olegv142/NRF51PowerMon/doc/rx_display_box.jpg

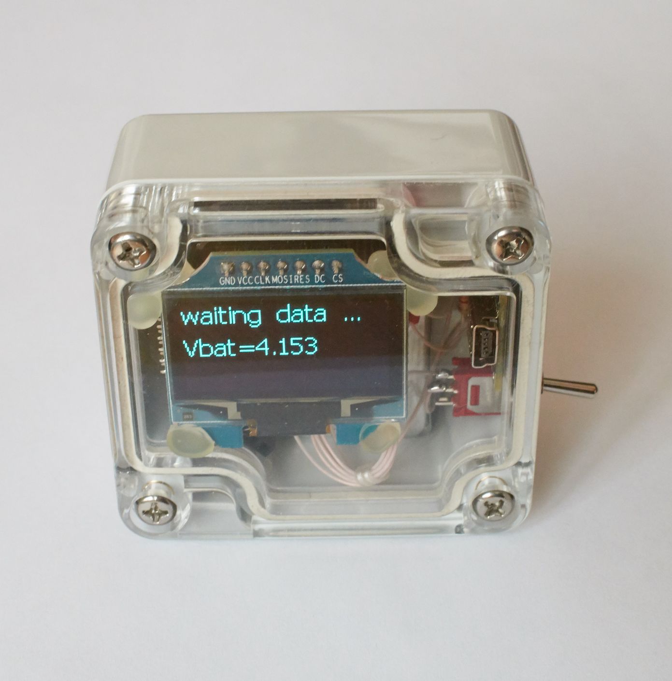
doc/rx_display_box.jpg
