olegv142/NRF51PowerMon/doc/rx_display.jpg

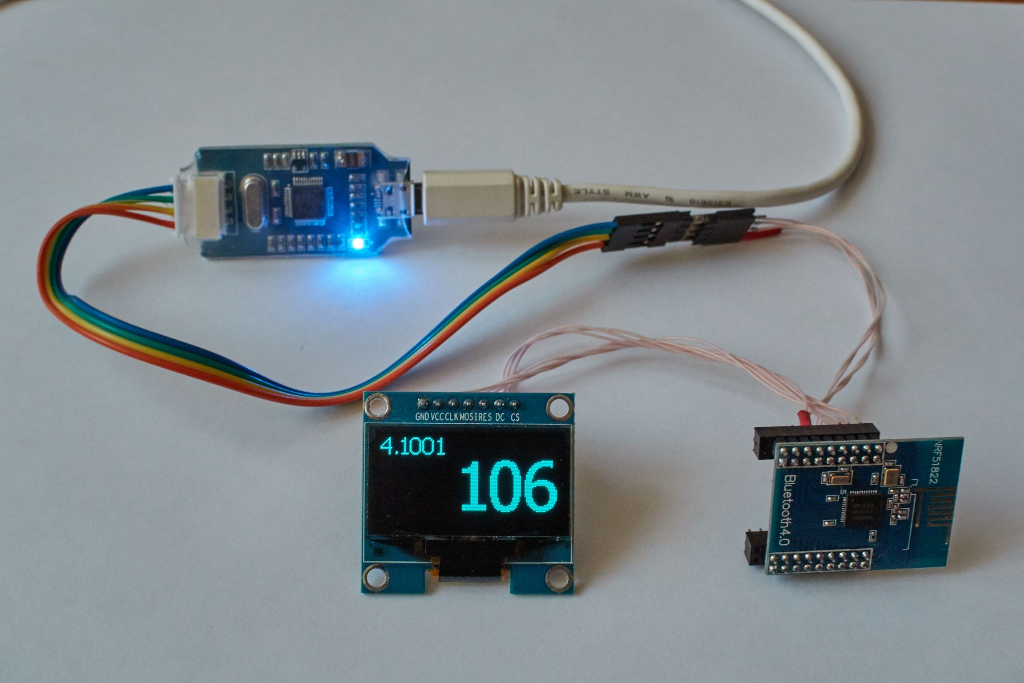
doc/rx_display.jpg
