olegv142/NRF51PowerMon/doc/receiver.jpg

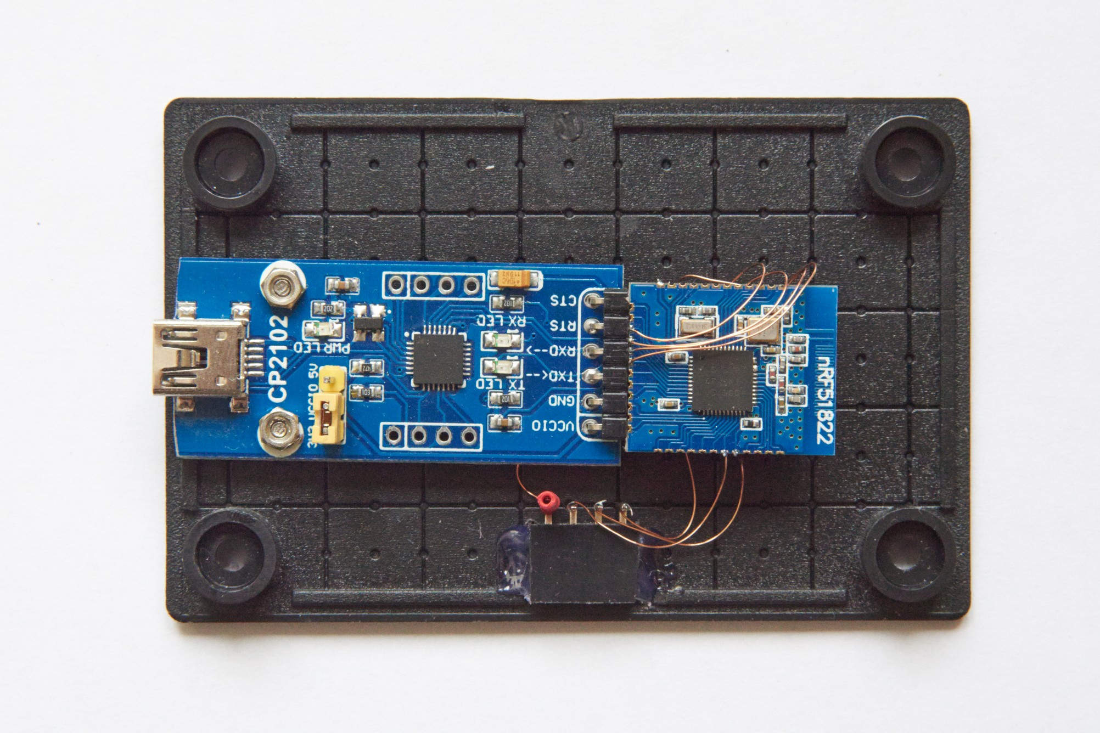
doc/receiver.jpg
