olegv142/NRF51PowerMon/components/device/nrf51_to_nrf52.h

/* Copyright (c) 2015, Nordic Semiconductor ASA
 * All rights reserved.
 *
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
 *   * Neither the name of Nordic Semiconductor ASA nor the names of its
 *     contributors may be used to endorse or promote products derived from
 *     this software without specific prior written permission.
 *
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
 */

#ifndef NRF51_TO_NRF52_H
#define NRF51_TO_NRF52_H

/*lint ++flb "Enter library region */

/* This file is given to prevent your SW from not compiling with the name changes between nRF51 and nRF52 devices. 
 * It redefines the old nRF51 names into the new ones as long as the functionality is still supported. If the 
 * functionality is gone, there old names are not define, so compilation will fail. Note that also includes macros 
 * from the nrf51_deprecated.h file. */

 
/* IRQ */
/* Several peripherals have been added to several indexes. Names of IRQ handlers and IRQ numbers have changed. */
#define UART0_IRQHandler        UARTE0_UART0_IRQHandler
#define SPI0_TWI0_IRQHandler    SPIM0_SPIS0_TWIM0_TWIS0_SPI0_TWI0_IRQHandler
#define SPI1_TWI1_IRQHandler    SPIM1_SPIS1_TWIM1_TWIS1_SPI1_TWI1_IRQHandler
#define ADC_IRQHandler          SAADC_IRQHandler
#define LPCOMP_IRQHandler       COMP_LPCOMP_IRQHandler
#define SWI0_IRQHandler         SWI0_EGU0_IRQHandler
#define SWI1_IRQHandler         SWI1_EGU1_IRQHandler
#define SWI2_IRQHandler         SWI2_EGU2_IRQHandler
#define SWI3_IRQHandler         SWI3_EGU3_IRQHandler
#define SWI4_IRQHandler         SWI4_EGU4_IRQHandler
#define SWI5_IRQHandler         SWI5_EGU5_IRQHandler

#define UART0_IRQn              UARTE0_UART0_IRQn
#define SPI0_TWI0_IRQn          SPIM0_SPIS0_TWIM0_TWIS0_SPI0_TWI0_IRQn
#define SPI1_TWI1_IRQn          SPIM1_SPIS1_TWIM1_TWIS1_SPI1_TWI1_IRQn
#define ADC_IRQn                SAADC_IRQn
#define LPCOMP_IRQn             COMP_LPCOMP_IRQn
#define SWI0_IRQn               SWI0_EGU0_IRQn
#define SWI1_IRQn               SWI1_EGU1_IRQn
#define SWI2_IRQn               SWI2_EGU2_IRQn
#define SWI3_IRQn               SWI3_EGU3_IRQn
#define SWI4_IRQn               SWI4_EGU4_IRQn
#define SWI5_IRQn               SWI5_EGU5_IRQn


/* UICR */
/* Register RBPCONF was renamed to APPROTECT. */
#define RBPCONF     APPROTECT

#define UICR_RBPCONF_PALL_Pos           UICR_APPROTECT_PALL_Pos
#define UICR_RBPCONF_PALL_Msk           UICR_APPROTECT_PALL_Msk
#define UICR_RBPCONF_PALL_Enabled       UICR_APPROTECT_PALL_Enabled
#define UICR_RBPCONF_PALL_Disabled      UICR_APPROTECT_PALL_Disabled


/* GPIO */
/* GPIO port was renamed to P0. */
#define NRF_GPIO        NRF_P0
#define NRF_GPIO_BASE   NRF_P0_BASE


/* SPIS */
/* The registers PSELSCK, PSELMISO, PSELMOSI, PSELCSN were restructured into a struct. */
#define PSELSCK       PSEL.SCK
#define PSELMISO      PSEL.MISO
#define PSELMOSI      PSEL.MOSI
#define PSELCSN       PSEL.CSN

/* The registers RXDPTR, MAXRX, AMOUNTRX were restructured into a struct */
#define RXDPTR        RXD.PTR
#define MAXRX         RXD.MAXCNT
#define AMOUNTRX      RXD.AMOUNT

#define SPIS_MAXRX_MAXRX_Pos        SPIS_RXD_MAXCNT_MAXCNT_Pos
#define SPIS_MAXRX_MAXRX_Msk        SPIS_RXD_MAXCNT_MAXCNT_Msk

#define SPIS_AMOUNTRX_AMOUNTRX_Pos  SPIS_RXD_AMOUNT_AMOUNT_Pos
#define SPIS_AMOUNTRX_AMOUNTRX_Msk  SPIS_RXD_AMOUNT_AMOUNT_Msk

/* The registers TXDPTR, MAXTX, AMOUNTTX were restructured into a struct */
#define TXDPTR        TXD.PTR
#define MAXTX         TXD.MAXCNT
#define AMOUNTTX      TXD.AMOUNT

#define SPIS_MAXTX_MAXTX_Pos        SPIS_TXD_MAXCNT_MAXCNT_Pos
#define SPIS_MAXTX_MAXTX_Msk        SPIS_TXD_MAXCNT_MAXCNT_Msk

#define SPIS_AMOUNTTX_AMOUNTTX_Pos  SPIS_TXD_AMOUNT_AMOUNT_Pos
#define SPIS_AMOUNTTX_AMOUNTTX_Msk  SPIS_TXD_AMOUNT_AMOUNT_Msk


/* MPU */
/* Part of MPU module was renamed BPROT, while the rest was eliminated. */
#define NRF_MPU     NRF_BPROT

/* Register DISABLEINDEBUG macros were affected. */
#define MPU_DISABLEINDEBUG_DISABLEINDEBUG_Pos       BPROT_DISABLEINDEBUG_DISABLEINDEBUG_Pos
#define MPU_DISABLEINDEBUG_DISABLEINDEBUG_Msk       BPROT_DISABLEINDEBUG_DISABLEINDEBUG_Msk
#define MPU_DISABLEINDEBUG_DISABLEINDEBUG_Enabled   BPROT_DISABLEINDEBUG_DISABLEINDEBUG_Enabled
#define MPU_DISABLEINDEBUG_DISABLEINDEBUG_Disabled  BPROT_DISABLEINDEBUG_DISABLEINDEBUG_Disabled

/* Registers PROTENSET0 and PROTENSET1 were affected and renamed as CONFIG0 and CONFIG1. */
#define PROTENSET0  CONFIG0
#define PROTENSET1  CONFIG1

#define MPU_PROTENSET1_PROTREG63_Pos        BPROT_CONFIG1_REGION63_Pos
#define MPU_PROTENSET1_PROTREG63_Msk        BPROT_CONFIG1_REGION63_Msk
#define MPU_PROTENSET1_PROTREG63_Disabled   BPROT_CONFIG1_REGION63_Disabled
#define MPU_PROTENSET1_PROTREG63_Enabled    BPROT_CONFIG1_REGION63_Enabled
#define MPU_PROTENSET1_PROTREG63_Set        BPROT_CONFIG1_REGION63_Enabled

#define MPU_PROTENSET1_PROTREG62_Pos        BPROT_CONFIG1_REGION62_Pos
#define MPU_PROTENSET1_PROTREG62_Msk        BPROT_CONFIG1_REGION62_Msk
#define MPU_PROTENSET1_PROTREG62_Disabled   BPROT_CONFIG1_REGION62_Disabled
#define MPU_PROTENSET1_PROTREG62_Enabled    BPROT_CONFIG1_REGION62_Enabled
#define MPU_PROTENSET1_PROTREG62_Set        BPROT_CONFIG1_REGION62_Enabled

#define MPU_PROTENSET1_PROTREG61_Pos        BPROT_CONFIG1_REGION61_Pos
#define MPU_PROTENSET1_PROTREG61_Msk        BPROT_CONFIG1_REGION61_Msk
#define MPU_PROTENSET1_PROTREG61_Disabled   BPROT_CONFIG1_REGION61_Disabled
#define MPU_PROTENSET1_PROTREG61_Enabled    BPROT_CONFIG1_REGION61_Enabled
#define MPU_PROTENSET1_PROTREG61_Set        BPROT_CONFIG1_REGION61_Enabled

#define MPU_PROTENSET1_PROTREG60_Pos        BPROT_CONFIG1_REGION60_Pos
#define MPU_PROTENSET1_PROTREG60_Msk        BPROT_CONFIG1_REGION60_Msk
#define MPU_PROTENSET1_PROTREG60_Disabled   BPROT_CONFIG1_REGION60_Disabled
#define MPU_PROTENSET1_PROTREG60_Enabled    BPROT_CONFIG1_REGION60_Enabled
#define MPU_PROTENSET1_PROTREG60_Set        BPROT_CONFIG1_REGION60_Enabled

#define MPU_PROTENSET1_PROTREG59_Pos        BPROT_CONFIG1_REGION59_Pos
#define MPU_PROTENSET1_PROTREG59_Msk        BPROT_CONFIG1_REGION59_Msk
#define MPU_PROTENSET1_PROTREG59_Disabled   BPROT_CONFIG1_REGION59_Disabled
#define MPU_PROTENSET1_PROTREG59_Enabled    BPROT_CONFIG1_REGION59_Enabled
#define MPU_PROTENSET1_PROTREG59_Set        BPROT_CONFIG1_REGION59_Enabled

#define MPU_PROTENSET1_PROTREG58_Pos        BPROT_CONFIG1_REGION58_Pos
#define MPU_PROTENSET1_PROTREG58_Msk        BPROT_CONFIG1_REGION58_Msk
#define MPU_PROTENSET1_PROTREG58_Disabled   BPROT_CONFIG1_REGION58_Disabled
#define MPU_PROTENSET1_PROTREG58_Enabled    BPROT_CONFIG1_REGION58_Enabled
#define MPU_PROTENSET1_PROTREG58_Set        BPROT_CONFIG1_REGION58_Enabled

#define MPU_PROTENSET1_PROTREG57_Pos        BPROT_CONFIG1_REGION57_Pos
#define MPU_PROTENSET1_PROTREG57_Msk        BPROT_CONFIG1_REGION57_Msk
#define MPU_PROTENSET1_PROTREG57_Disabled   BPROT_CONFIG1_REGION57_Disabled
#define MPU_PROTENSET1_PROTREG57_Enabled    BPROT_CONFIG1_REGION57_Enabled
#define MPU_PROTENSET1_PROTREG57_Set        BPROT_CONFIG1_REGION57_Enabled

#define MPU_PROTENSET1_PROTREG56_Pos        BPROT_CONFIG1_REGION56_Pos
#define MPU_PROTENSET1_PROTREG56_Msk        BPROT_CONFIG1_REGION56_Msk
#define MPU_PROTENSET1_PROTREG56_Disabled   BPROT_CONFIG1_REGION56_Disabled
#define MPU_PROTENSET1_PROTREG56_Enabled    BPROT_CONFIG1_REGION56_Enabled
#define MPU_PROTENSET1_PROTREG56_Set        BPROT_CONFIG1_REGION56_Enabled

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
#define MPU_PROTENSET0_PROTREG4_Msk        BPROT_CONFIG0_REGION4_Msk
#define MPU_PROTENSET0_PROTREG4_Disabled   BPROT_CONFIG0_REGION4_Disabled
#define MPU_PROTENSET0_PROTREG4_Enabled    BPROT_CONFIG0_REGION4_Enabled
#define MPU_PROTENSET0_PROTREG4_Set        BPROT_CONFIG0_REGION4_Enabled

#define MPU_PROTENSET0_PROTREG3_Pos        BPROT_CONFIG0_REGION3_Pos
#define MPU_PROTENSET0_PROTREG3_Msk        BPROT_CONFIG0_REGION3_Msk
#define MPU_PROTENSET0_PROTREG3_Disabled   BPROT_CONFIG0_REGION3_Disabled
#define MPU_PROTENSET0_PROTREG3_Enabled    BPROT_CONFIG0_REGION3_Enabled
#define MPU_PROTENSET0_PROTREG3_Set        BPROT_CONFIG0_REGION3_Enabled

#define MPU_PROTENSET0_PROTREG2_Pos        BPROT_CONFIG0_REGION2_Pos
#define MPU_PROTENSET0_PROTREG2_Msk        BPROT_CONFIG0_REGION2_Msk
#define MPU_PROTENSET0_PROTREG2_Disabled   BPROT_CONFIG0_REGION2_Disabled
#define MPU_PROTENSET0_PROTREG2_Enabled    BPROT_CONFIG0_REGION2_Enabled
#define MPU_PROTENSET0_PROTREG2_Set        BPROT_CONFIG0_REGION2_Enabled

#define MPU_PROTENSET0_PROTREG1_Pos        BPROT_CONFIG0_REGION1_Pos
#define MPU_PROTENSET0_PROTREG1_Msk        BPROT_CONFIG0_REGION1_Msk
#define MPU_PROTENSET0_PROTREG1_Disabled   BPROT_CONFIG0_REGION1_Disabled
#define MPU_PROTENSET0_PROTREG1_Enabled    BPROT_CONFIG0_REGION1_Enabled
#define MPU_PROTENSET0_PROTREG1_Set        BPROT_CONFIG0_REGION1_Enabled

#define MPU_PROTENSET0_PROTREG0_Pos        BPROT_CONFIG0_REGION0_Pos
#define MPU_PROTENSET0_PROTREG0_Msk        BPROT_CONFIG0_REGION0_Msk
#define MPU_PROTENSET0_PROTREG0_Disabled   BPROT_CONFIG0_REGION0_Disabled
#define MPU_PROTENSET0_PROTREG0_Enabled    BPROT_CONFIG0_REGION0_Enabled
#define MPU_PROTENSET0_PROTREG0_Set        BPROT_CONFIG0_REGION0_Enabled


/* From nrf51_deprecated.h */

/* NVMC */
/* The register ERASEPROTECTEDPAGE changed name to ERASEPCR0 in the documentation. */
#define ERASEPROTECTEDPAGE      ERASEPCR0


/* IRQ */
/* COMP module was eliminated. Adapted to nrf52 headers. */
#define LPCOMP_COMP_IRQHandler  COMP_LPCOMP_IRQHandler
#define LPCOMP_COMP_IRQn        COMP_LPCOMP_IRQn


/* RADIO */
/* The name of the field SKIPADDR was corrected. Old macros added for compatibility. */
#define RADIO_CRCCNF_SKIP_ADDR_Pos      RADIO_CRCCNF_SKIPADDR_Pos 
#define RADIO_CRCCNF_SKIP_ADDR_Msk      RADIO_CRCCNF_SKIPADDR_Msk 
#define RADIO_CRCCNF_SKIP_ADDR_Include  RADIO_CRCCNF_SKIPADDR_Include 
#define RADIO_CRCCNF_SKIP_ADDR_Skip     RADIO_CRCCNF_SKIPADDR_Skip 


/* FICR */
/* The registers FICR.DEVICEID0 and FICR.DEVICEID1 were renamed into an array. */
#define DEVICEID0       DEVICEID[0]                     
#define DEVICEID1       DEVICEID[1]  

/* The registers FICR.ER0, FICR.ER1, FICR.ER2 and FICR.ER3 were renamed into an array. */
#define ER0             ER[0]                           
#define ER1             ER[1]                          
#define ER2             ER[2]                       
#define ER3             ER[3]                      

/* The registers FICR.IR0, FICR.IR1, FICR.IR2 and FICR.IR3 were renamed into an array. */
#define IR0             IR[0]                         
#define IR1             IR[1]                         
#define IR2             IR[2]                         
#define IR3             IR[3]                          

/* The registers FICR.DEVICEADDR0 and FICR.DEVICEADDR1 were renamed into an array. */
#define DEVICEADDR0     DEVICEADDR[0]                  
#define DEVICEADDR1     DEVICEADDR[1] 


/* PPI */
/* The tasks PPI.TASKS_CHGxEN and PPI.TASKS_CHGxDIS were renamed into an array of structs. */
#define TASKS_CHG0EN     TASKS_CHG[0].EN                    
#define TASKS_CHG0DIS    TASKS_CHG[0].DIS                  
#define TASKS_CHG1EN     TASKS_CHG[1].EN                    
#define TASKS_CHG1DIS    TASKS_CHG[1].DIS                  
#define TASKS_CHG2EN     TASKS_CHG[2].EN                   
#define TASKS_CHG2DIS    TASKS_CHG[2].DIS                  
#define TASKS_CHG3EN     TASKS_CHG[3].EN                    
#define TASKS_CHG3DIS    TASKS_CHG[3].DIS                  

/* The registers PPI.CHx_EEP and PPI.CHx_TEP were renamed into an array of structs. */
#define CH0_EEP          CH[0].EEP                          
#define CH0_TEP          CH[0].TEP                          
#define CH1_EEP          CH[1].EEP                         
#define CH1_TEP          CH[1].TEP                         
#define CH2_EEP          CH[2].EEP                          
#define CH2_TEP          CH[2].TEP                         
#define CH3_EEP          CH[3].EEP                          
#define CH3_TEP          CH[3].TEP                         
#define CH4_EEP          CH[4].EEP                         
#define CH4_TEP          CH[4].TEP                         
#define CH5_EEP          CH[5].EEP                          
#define CH5_TEP          CH[5].TEP                          
#define CH6_EEP          CH[6].EEP                          
#define CH6_TEP          CH[6].TEP                         
#define CH7_EEP          CH[7].EEP                          
#define CH7_TEP          CH[7].TEP                          
#define CH8_EEP          CH[8].EEP                         
#define CH8_TEP          CH[8].TEP                          
#define CH9_EEP          CH[9].EEP                          
#define CH9_TEP          CH[9].TEP                          
#define CH10_EEP         CH[10].EEP                         
#define CH10_TEP         CH[10].TEP                         
#define CH11_EEP         CH[11].EEP                         
#define CH11_TEP         CH[11].TEP                         
#define CH12_EEP         CH[12].EEP                         
#define CH12_TEP         CH[12].TEP                         
#define CH13_EEP         CH[13].EEP                         
#define CH13_TEP         CH[13].TEP                         
#define CH14_EEP         CH[14].EEP                         
#define CH14_TEP         CH[14].TEP                         
#define CH15_EEP         CH[15].EEP                         
#define CH15_TEP         CH[15].TEP                        

/* The registers PPI.CHG0, PPI.CHG1, PPI.CHG2 and PPI.CHG3 were renamed into an array. */
#define CHG0             CHG[0]                            
#define CHG1             CHG[1]                            
#define CHG2             CHG[2]                             
#define CHG3             CHG[3]                           

/* All bitfield macros for the CHGx registers therefore changed name. */
#define PPI_CHG0_CH15_Pos       PPI_CHG_CH15_Pos            
#define PPI_CHG0_CH15_Msk       PPI_CHG_CH15_Msk            
#define PPI_CHG0_CH15_Excluded  PPI_CHG_CH15_Excluded       
#define PPI_CHG0_CH15_Included  PPI_CHG_CH15_Included  
     
#define PPI_CHG0_CH14_Pos       PPI_CHG_CH14_Pos            
#define PPI_CHG0_CH14_Msk       PPI_CHG_CH14_Msk           
#define PPI_CHG0_CH14_Excluded  PPI_CHG_CH14_Excluded       
#define PPI_CHG0_CH14_Included  PPI_CHG_CH14_Included     
  
#define PPI_CHG0_CH13_Pos       PPI_CHG_CH13_Pos            
#define PPI_CHG0_CH13_Msk       PPI_CHG_CH13_Msk            
#define PPI_CHG0_CH13_Excluded  PPI_CHG_CH13_Excluded      
#define PPI_CHG0_CH13_Included  PPI_CHG_CH13_Included   
    
#define PPI_CHG0_CH12_Pos       PPI_CHG_CH12_Pos            
#define PPI_CHG0_CH12_Msk       PPI_CHG_CH12_Msk            
#define PPI_CHG0_CH12_Excluded  PPI_CHG_CH12_Excluded       
#define PPI_CHG0_CH12_Included  PPI_CHG_CH12_Included   
    
#define PPI_CHG0_CH11_Pos       PPI_CHG_CH11_Pos            
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
#define PPI_CHG3_CH5_Excluded   PPI_CHG_CH5_Excluded        
#define PPI_CHG3_CH5_Included   PPI_CHG_CH5_Included  
     
#define PPI_CHG3_CH4_Pos        PPI_CHG_CH4_Pos             
#define PPI_CHG3_CH4_Msk        PPI_CHG_CH4_Msk            
#define PPI_CHG3_CH4_Excluded   PPI_CHG_CH4_Excluded        
#define PPI_CHG3_CH4_Included   PPI_CHG_CH4_Included  
      
#define PPI_CHG3_CH3_Pos        PPI_CHG_CH3_Pos             
#define PPI_CHG3_CH3_Msk        PPI_CHG_CH3_Msk            
#define PPI_CHG3_CH3_Excluded   PPI_CHG_CH3_Excluded        
#define PPI_CHG3_CH3_Included   PPI_CHG_CH3_Included   
     
#define PPI_CHG3_CH2_Pos        PPI_CHG_CH2_Pos             
#define PPI_CHG3_CH2_Msk        PPI_CHG_CH2_Msk             
#define PPI_CHG3_CH2_Excluded   PPI_CHG_CH2_Excluded        
#define PPI_CHG3_CH2_Included   PPI_CHG_CH2_Included  
     
#define PPI_CHG3_CH1_Pos        PPI_CHG_CH1_Pos             
#define PPI_CHG3_CH1_Msk        PPI_CHG_CH1_Msk             
#define PPI_CHG3_CH1_Excluded   PPI_CHG_CH1_Excluded        
#define PPI_CHG3_CH1_Included   PPI_CHG_CH1_Included  
      
#define PPI_CHG3_CH0_Pos        PPI_CHG_CH0_Pos             
#define PPI_CHG3_CH0_Msk        PPI_CHG_CH0_Msk             
#define PPI_CHG3_CH0_Excluded   PPI_CHG_CH0_Excluded        
#define PPI_CHG3_CH0_Included   PPI_CHG_CH0_Included        




/*lint --flb "Leave library region" */

#endif /* NRF51_TO_NRF52_H */
