olegv142/NRF51PowerMon/(commit log)

2016-05-25 Power and VCC reporting
2016-05-30 Power saving modes
2016-05-31 Charge control pin changed to P0
2016-05-31 Missing cleanup in radio
    [radio.c]
2016-05-31 Print last SN and the numbre of packets
2016-05-31 Using watchdog timer
2016-05-31 Calibration coefficient
2016-05-31 Calibration corrected
2016-06-02 Batter current trace added to doc
2016-06-04 UART protocol skeleton
2016-06-05 UART protocol completed
2016-06-06 Don't increase timeout in case packet already received
2016-06-06 Battery voltage resolution improved
2016-06-08 Fail data transfer in case transiver is reporting low battery status
    [main.c]
2016-12-13 Show battery voltage on startup
